gficht/OpenServo/img/electro.jpg

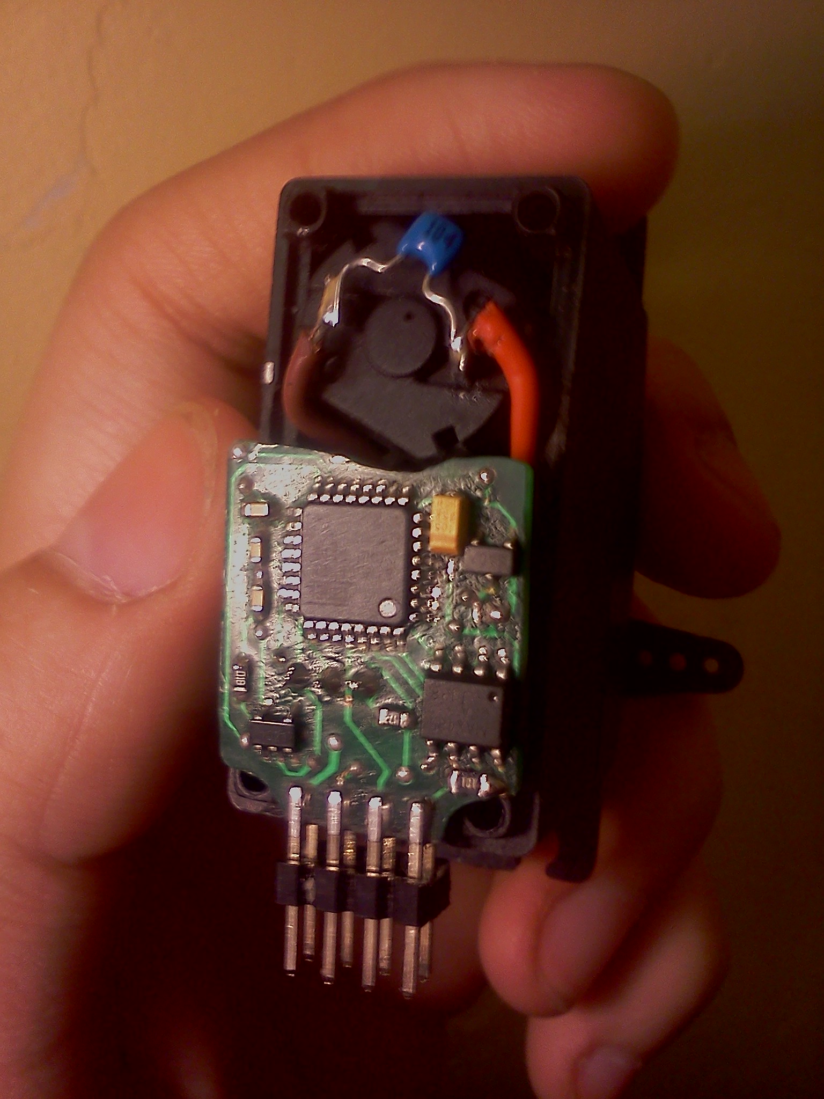
img/electro.jpg
