gficht/OpenServo/img/module.jpg

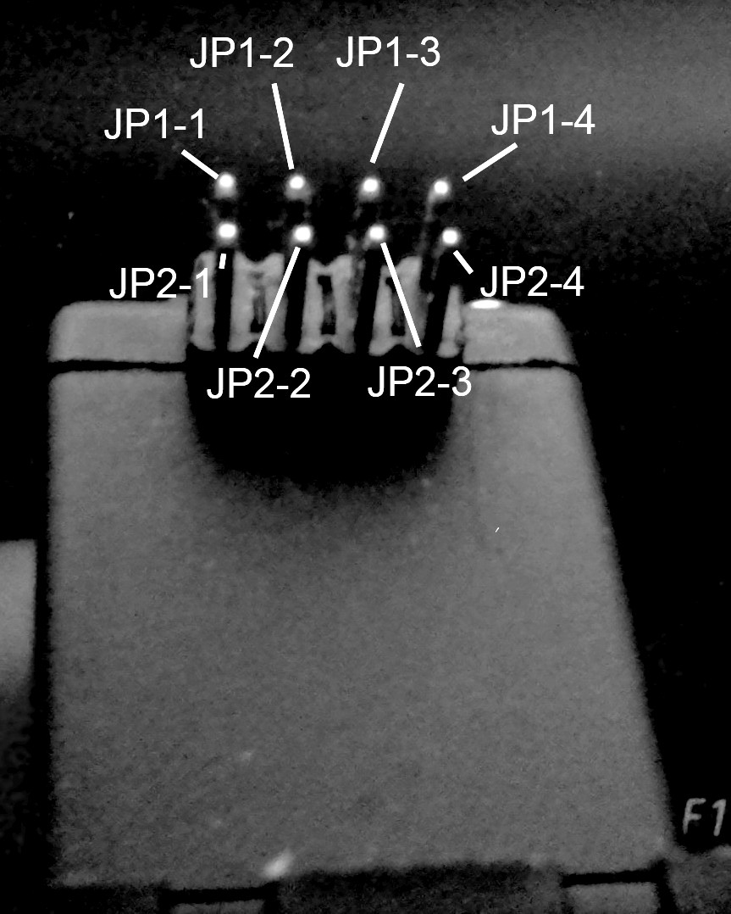
img/module.jpg
