gficht/OpenServo/tolinski.pdf

# Sterowniki robotów Projekt Openservo

### Jarosław Toli ´nski

### 31 maja 2012

## Spis tre´sci

1 Wst ˛ep teoretyczny | 3
1.2 Załozenia projektowe | ˙ | 3
1.3 Róznice | ˙ | 3
2 Hardware | 6
3 Oprogramowanie | 7
4 Dokumentacja programu | 8

## 1 Wst ˛ep teoretyczny

### 1.1 Czym jest Openservo?

OpenServo jest otwartym projektem zakładaj ˛acym projektowanie, budowanie oraz programowanie układów pełni ˛acych role sterowników do serwomechanizmów, prowadzonym przez Barry Carter’ a,

### 1.2 Załozenia projektowe ˙

Celem projektu było stworzenie sterownika seromechanizmu zdolnego do komunikacji po RS485. Na podstawie celów projektu wyznaczono nast ˛epuj ˛ace załozenia ˙ projektowe:

- zaprojektowanie układu elektronicznego oraz płytki PCB na podstawie projektu OpenServo,
- zmaksymalizowanie wykorzytania dost ˛epnego w ramach projektu OpenServo kodu i dodanie do niego załozonych wczesniej funkcjonalno´sci. ˙

### 1.3 Róznice ˙

Aby zapewni´c mozliwo´s´c komunikacji tworzonego OpenServa z u ˙ | zyciem RS485, do ˙
oryginalnego projektu elektroniki oraz firmware-u OpenServa wprowadzono kilka zmian:
- dodano układ MAX485, słuz ˛acy do komunikacji za pomoc ˛a interfejsu RS485, ˙
- ze wzgl ˛edu na niedost ˛epno´s´c oryginalnego regulatora napi ˛ecia, zast ˛apiono go układem MCP1701AT-5002I/CB, co wymusiło równiez zmian ˛e kondensa- ˙ torów w sekcji zasilania,
- z powodu konieczno´sci zarezerwowania miejsca na zł ˛aczu dla poł ˛acze ´n A i B interfejsu RS485, nie wyprowadzono lini SDA mikrokontrolera, co permanentnie uniemozliwia wykorzystanie TWI, ˙
- dodano obsług ˛e portu UART,
- utworzono namiastk ˛e protokołu słuz ˛acego do bezpiecznego zarz ˛adzania ser- ˙ wem,
- utworzono funkcje obsługuj ˛ace komendy OpenServa.

Sposób kontrolowania zaprojektowanego OpenServa jest podobny do oryginalnego projektu. Róznice to konieczno´s´c stosowania interfejsu RS485 oraz zastosowanie ˙ odpowiedniego protokołu komunikacji z serwem. Podobnie jak w przypadku komunikacji przez TWI, wymagane jest wysłanie: adresu serwa, komendy/polecenia, zaleznie od komendy, dodatkowo dwóch 16-bitowych słów danych (adresu re- ˙ jestru,zapisywana warto´s´c) oraz sumy CRC(modbus, polynomial 0xa001, warto´s´c pocz ˛atkowa 0xffff), słuz ˛acej do sprawdzenia poprawno´sci odebranych danych. ˙

### 1.4 Zł ˛acze modułu

Zł ˛acze modułu ma spełnia´c 3 funkcj ˛e: zasilania, komunikacji oraz programowania wewn ˛etrznego mikrokontrolera.


Rysunek 1: Zł ˛acze modułu

Tabela 1: Opis wyprowadze ´n modułu
Oznaczenie | Opis
JP1-1 | Zł ˛acze zasilania 6V (10V Max) lub 5V w trybie programowania
JP1-2 | Masa (GND)
JP1-3 | SCK (programowanie)
JP1-4 | Wyprowadzenie A interfejsu RS485
JP2-1 | MOSI(programowanie)
JP2-2 | MISO(programowanie)
JP2-3 | RESET (programowanie)
JP2-4 | Wyprowadzenie B interfejsu RS485

### 1.5 Komunikacja

Komunikacja z uzyciem portu UART odbywa si ˛e przy pr˛edko´sci transmisji (bau- ˙ drate) równej 19200. Zgodnie z ide ˛a interfejsu RS485, serwo jako urz ˛adzenie typu slave oczekuje rozkazów, wysyłaj ˛ac dane tylko wtedy kiedy wysłane zostanie odpowiednie z ˛adanie. W celu zapewnienia poprawno´sci transmisji oraz jak najlepszej ˙ integracji z istniej ˛acym firmwarem OpenServa zdecydowano si ˛e na stworzenie namiastki protokołu komunikacji. Komunikacja z serwem opiera si ˛e na wysyłaniu oraz ewentualnie odbieraniu ramek danych. Kazda ramka składa si ˛e z 9 bajtów ˙ danych. Dzi ˛eki temu mozliwe jest zaadresowanie 255 urz ˛adze ´n (0=adres broad- ˙
cast), zapiywanie i zadanie odczytania ka ˙ | zdego z rejetrów za pomoc ˛a jednej ramki ˙
danych przy jednoczesnej gwarancji spójno´sci i poprawno´sci zapisanych/odczytanych danych. Sterowanie serwem opiera si ˛e na tej samej zasadzie jak w oryginalnym projekcie: zmiana pozycji, nastaw PID, lub jakichkolwiek innych ustawie ´n nast ˛epuje poprzez zapis danych (pozycji, nastaw) do odpowiednich rejestrów. Domy´slny adres urz ˛adzenia to 0x10. Zmiana rejestru jest mozliwa z poziomu kodu ˙ oraz przez zapis odpowiedniego rejestru. Rejestr pozycji serwa jest 16-bitowy, jed-

Tabela 2: Opis ramki danych
Zawiera: | Bajt:
1 | ’<’
2 | adres urz ˛adzenia
3 | polecenie
4 | MSB data1
5 | LSB data1
6 | MSB data2
7 | LSB data2
8 | MSB CRC16
9 | LSB CRC16

nak wykorzystywany zakres warto´sci to 0-1023. W OpenServie dodatkowo wpro-
wadzona jest blokada maj ˛aca na celu ograniczenie zuzycia serwa zaw ˛e ˙ | zaj ˛ace ten ˙
zakres do 96-928. Działanie wszystkich rejestrów jest tozsame z oryginalnym. Je- ˙ dyn ˛a róznic ˛a jest brak blokady zapisu istotnych rejestrów. ˙

## 2 Hardware

### 2.1 Projekt

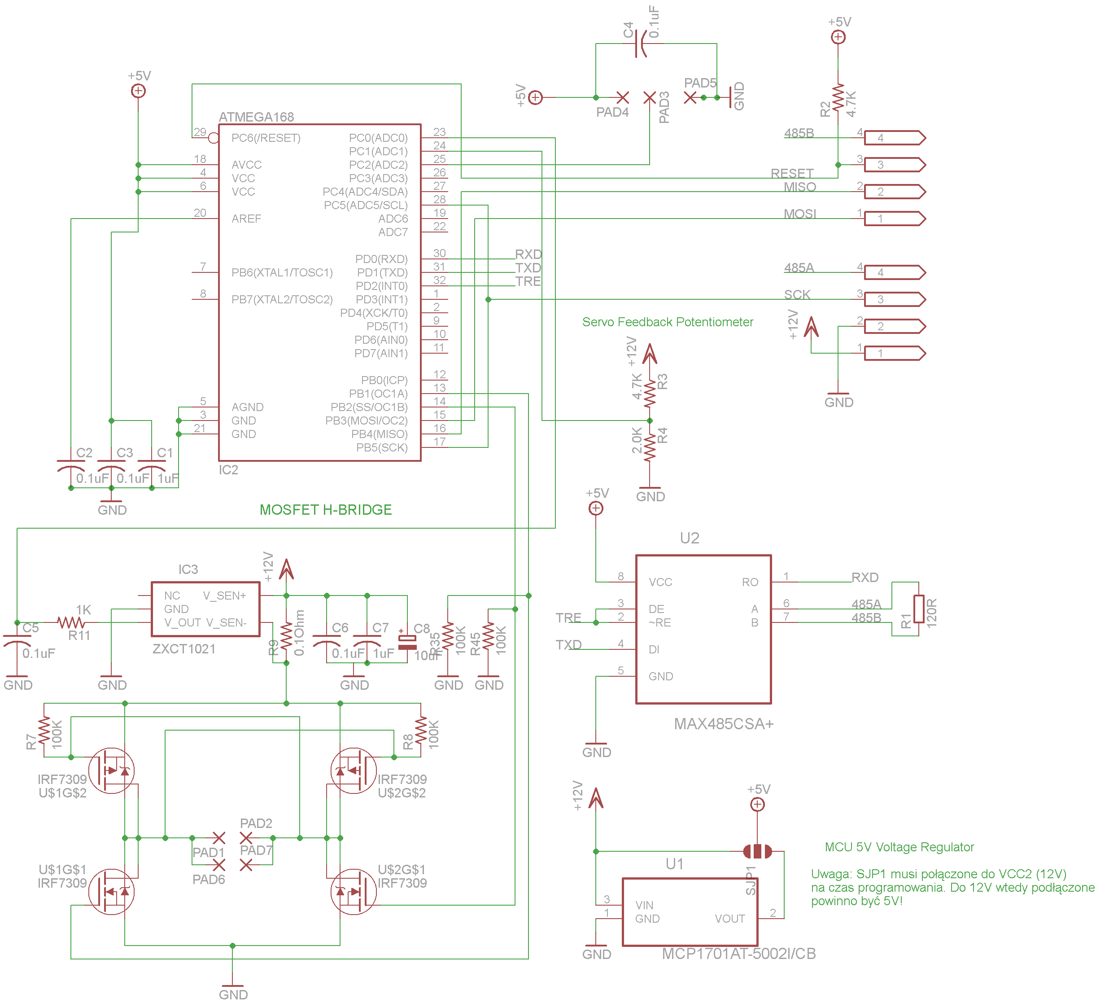
[picture p3: figure]

Rysunek 2: Schemat

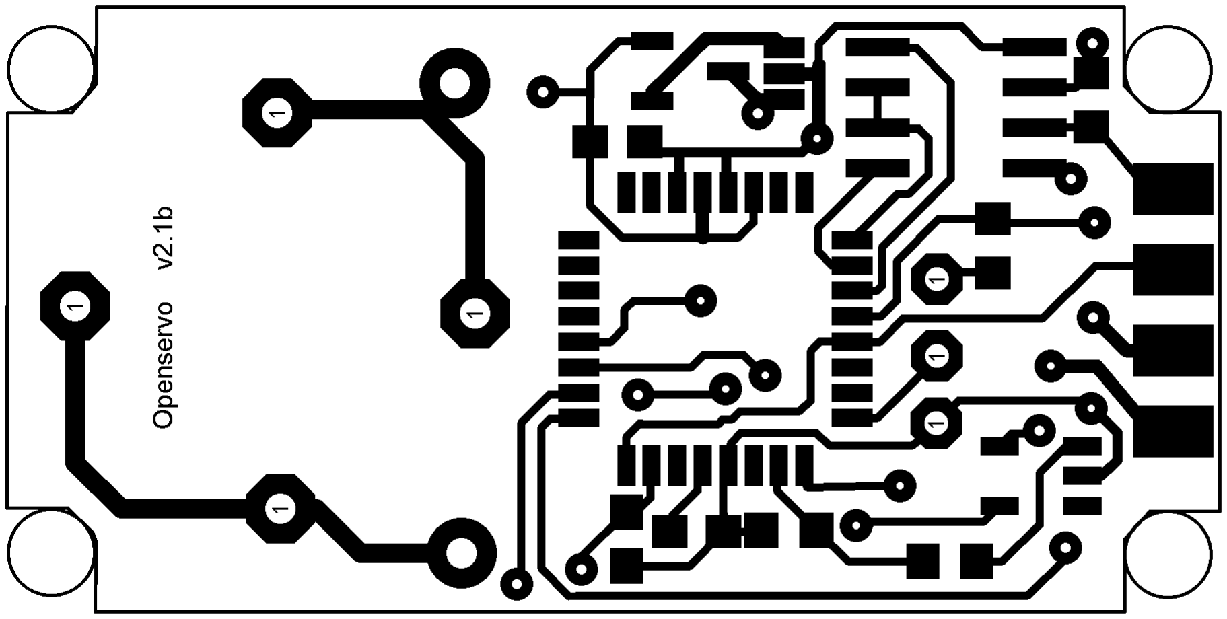
[picture p4: figure]

Rysunek 3: Projekt PCB (góra)

## 3 Oprogramowanie

Firmware urz ˛adzenia opiera si ˛e głównie na oryginalnym oprogramowaniu Open-Serva. Zostało ono odpowiednio rozszerzone aby spełnia´c cele i załozenia pro- ˙ jektu. Ponadto niezaimplementowana został ˛a ochrona waznych rejestrów - polece- ˙ nia WRITE_ENABLE, WRITE_DISABLE nie maj ˛a efektu. Nastawy PID zostały dobrane metod ˛a Zieglera-Nicholsa. Tabela rejetrów pobrana ze strony Projektu Open-Servo:

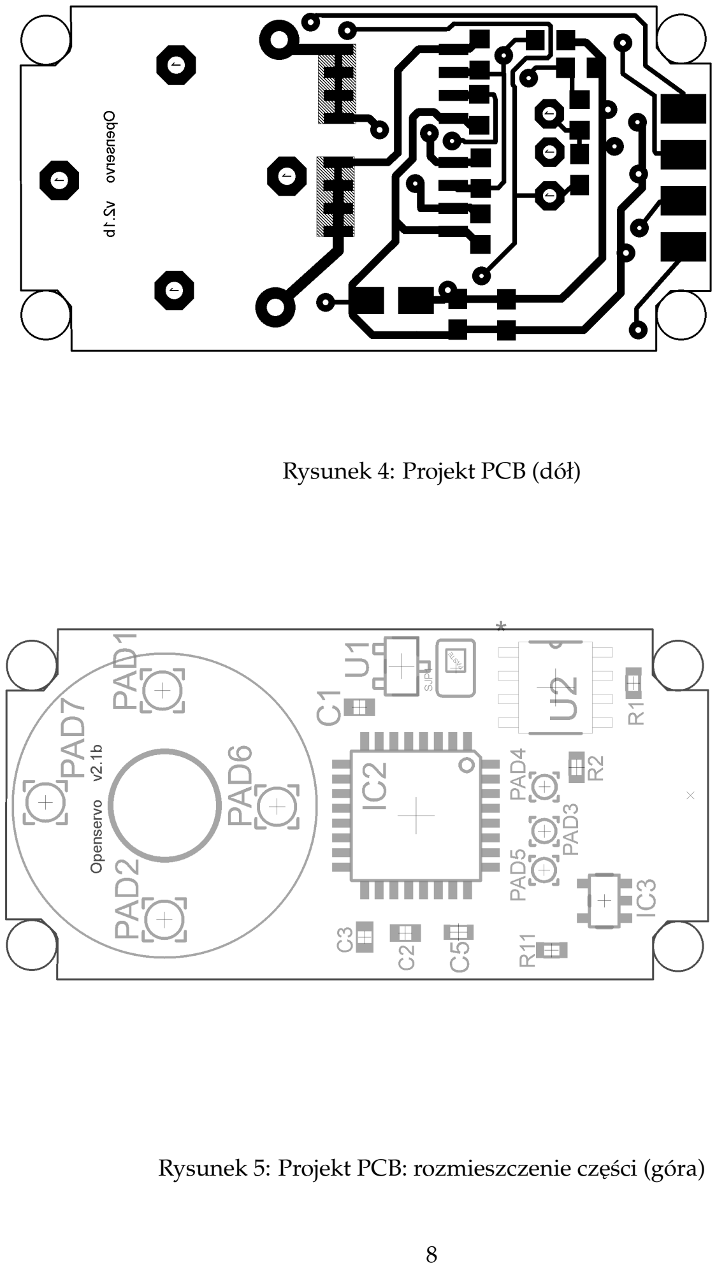
[picture p5: page 8]

Rysunek 4: Projekt PCB (dół)

Rysunek 5: Projekt PCB: rozmieszczenie cz ˛e´sci (góra)

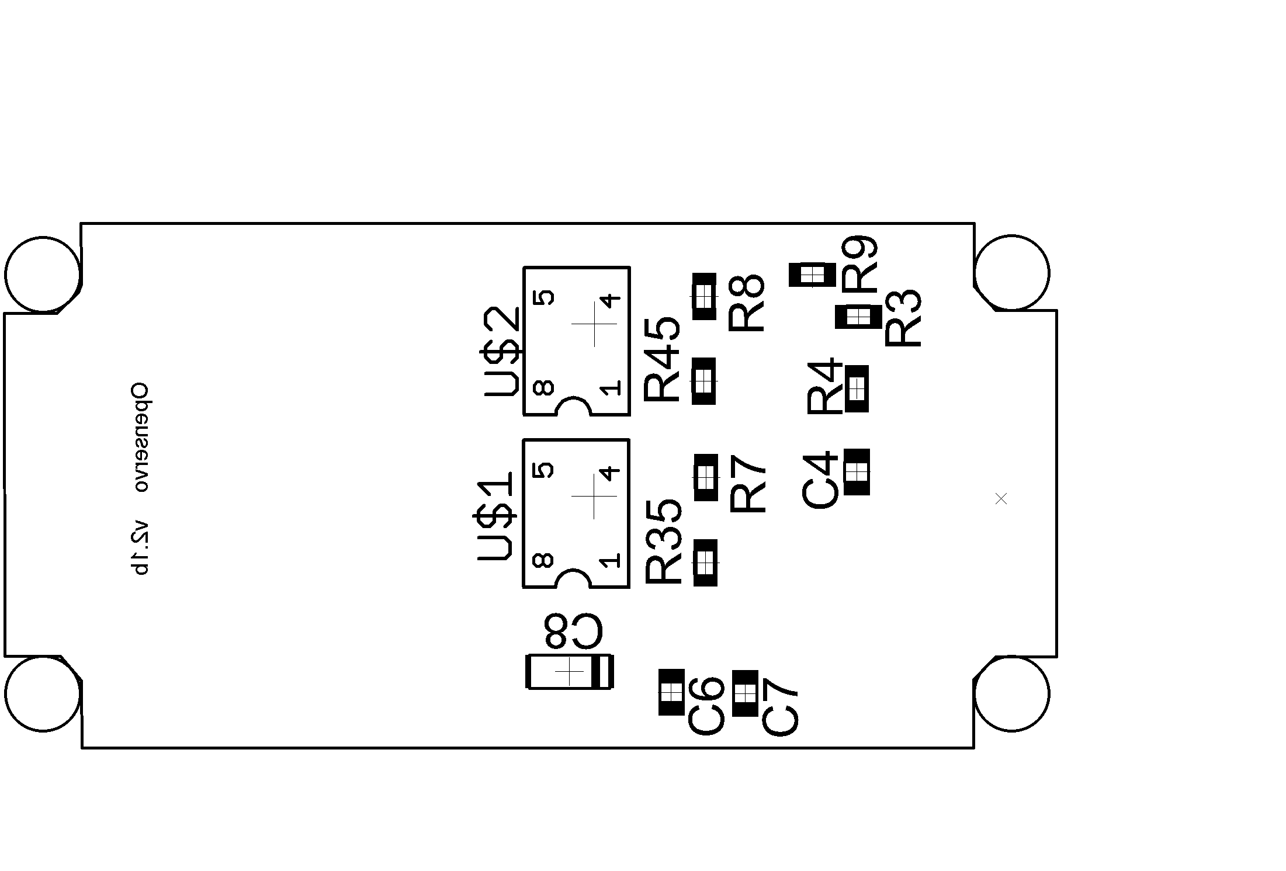
[picture p6: figure]

Rysunek 6: Projekt PCB: rozmieszczenie cz ˛e´sci (dół)


Rysunek 7: Projekt PCB (góra)

Tabela 3: Rejestry OpenServa
Address | Name | Type | Description
0x00 | DEVICE_TYPE | R/O | Device type - 1
0x01 | DEVICE_SUBTYPE | R/O | Device subtype - 1
0x02 | VERSION_MAJOR | R/O | Major version number
0x03 | VERSION_MINOR | R/O | Minor version number
0x04 | FLAGS_HI | R/O | Flags high byte
0x05 | FLAGS_LO | R/O | Flags low byte
0x06 | TIMER_HI | R/O | Timer high byte
0x07 | TIMER_LO | R/O | Timer low byte
0x08 | POSITION_HI | R/O | Servo position high byte
0x09 | POSITION_LO | R/O | Servo position low byte
0x0A | VELOCITY_HI | R/O | Servo velocity high byte
0x0B | VELOCITY_LO | R/O | Servo velocity low byte
0x0C | POWER_HI | R/O | Servo power high byte
0x0D | POWER_LO | R/O | Servo power low byte
0x0E | PWM_CW | R/O | PWM clockwise value
0x0F | PWM_CCW | R/O | PWM counter-clockwise value
0x10 | SEEK_HI | R/W | Seek position high byte
0x11 | SEEK_LO | R/W | Seek position low byte
0x12 | SEEK_VELOCITY_HI | R/W | Speed seek position high byte
0x13 | SEEK_VELOCITY_LO | R/W | Speed seek position low byte
0x14 | VOLTAGE_HI | R/W | Battery Voltage value high byte
0x15 | VOLTAGE_LO | R/W | Battery Voltage value low byte
0x16 | CURVE_RESERVED | R/W | reserved curve data
0x17 | CURVE_BUFFER | R/W | Remaining curve buffer space
0x18 | CURVE_DELTA_HI | R/W | Curve Time delta high byte
0x19 | CURVE_DELTA_LO | R/W | Curve Time delta low byte
0x1A | CURVE_POSITION_HI | R/W | Curve position high byte
0x1B | CURVE_POSITION_LO | R/W | Curve position low byte
0x1C | CURVE_IN_VELOCITY_HI | R/W | Curve in velocity high byte
0x1D | CURVE_IN_VELOCITY_LO | R/W | Curve in velocity low byte
0x1E | CURVE_OUT_VELOCITY_HI | R/W | Curve out velocity high byte
0x1F | CURVE_OUT_VELOCITY_LO | R/W | Curve out velocity low byte
0x20 | TWI_ADDRESS | R/W P | TWI address of servo
0x21 | PID_DEADBAND | R/W P | Programmable PID deadband value
0x22 | PID_PGAIN_HI | R/W P | PID proportional gain high byte
0x23 | PID_PGAIN_LO | R/W P | PID proportional gain low byte
0x24 | PID_DGAIN_HI | R/W P | PID derivative gain high byte
0x25 | PID_DGAIN_LO | R/W P | PID derivative gain low byte
0x26 | PID_IGAIN_HI | R/W P | PID integral gain high byte
0x27 | PID_IGAIN_LO | R/W P | PID integral gain low byte
0x28 | PWM_FREQ_DIVIDER_HI | R/W P | PWM frequency divider high byte
0x29 | PWM_FREQ_DIVIDER_LO | R/W P | PWM frequency divider low byte
0x2A | MIN_SEEK_HI | R/W P | Minimum seek position high byte
0x2B | MIN_SEEK_LO | R/W P | Minimum seek position low byte
0x2C | MAX_SEEK_HI | R/W P | Maximum seek position high byte
0x2D | MAX_SEEK_LO | R/W P | Maximum seek position low byte
0x2E | REVERSE_SEEK | R/W P | Reverse seek sense
0x2F | RESERVED | R/W P

Tabela 4: Komendy OpenServa
Command | Name | Description
0x00...0x7F | reserved | Reserved for data addresses (msb = 0)
0x80 | RESET | Reset microcontroller
0x81 | CHECKED_TXN | Read/Write registers with simple checksum
0x82 | PWM_ENABLE | Enable PWM to motors
0x83 | PWM_DISABLE | Disable PWM to servo motors
0x84 | WRITE_ENABLE | Enable write of r/w protected registers
0x85 | WRITE_DISABLE | Disable write of r/w protected registers
0x86 | REGISTERS_SAVE | Save r/w protected registers fo EEPROM
0x87 | REGISTERS_RESTORE | Restore r/w protected registers from EEPROM
0x88 | REGISTERS_DEFAULT | Restore r/w protected registers to defaults
0x89 | EEPROM_ERASE | Erase the AVR EEPROM
0x90 | VOLTAGE_READ | Request a new Voltage sample
0x91 | CURVE_MOTION_ENABLE | Enable curve based motion
0x92 | CURVE_MOTION_DISABLE | Disable curve based motion
0x93 | CURVE_MOTION_RESET | Clear the curve buffer
0x94 | CURVE_MOTION_APPEND | Append a new curve
