gficht/OpenServo/adapter/adapter.png

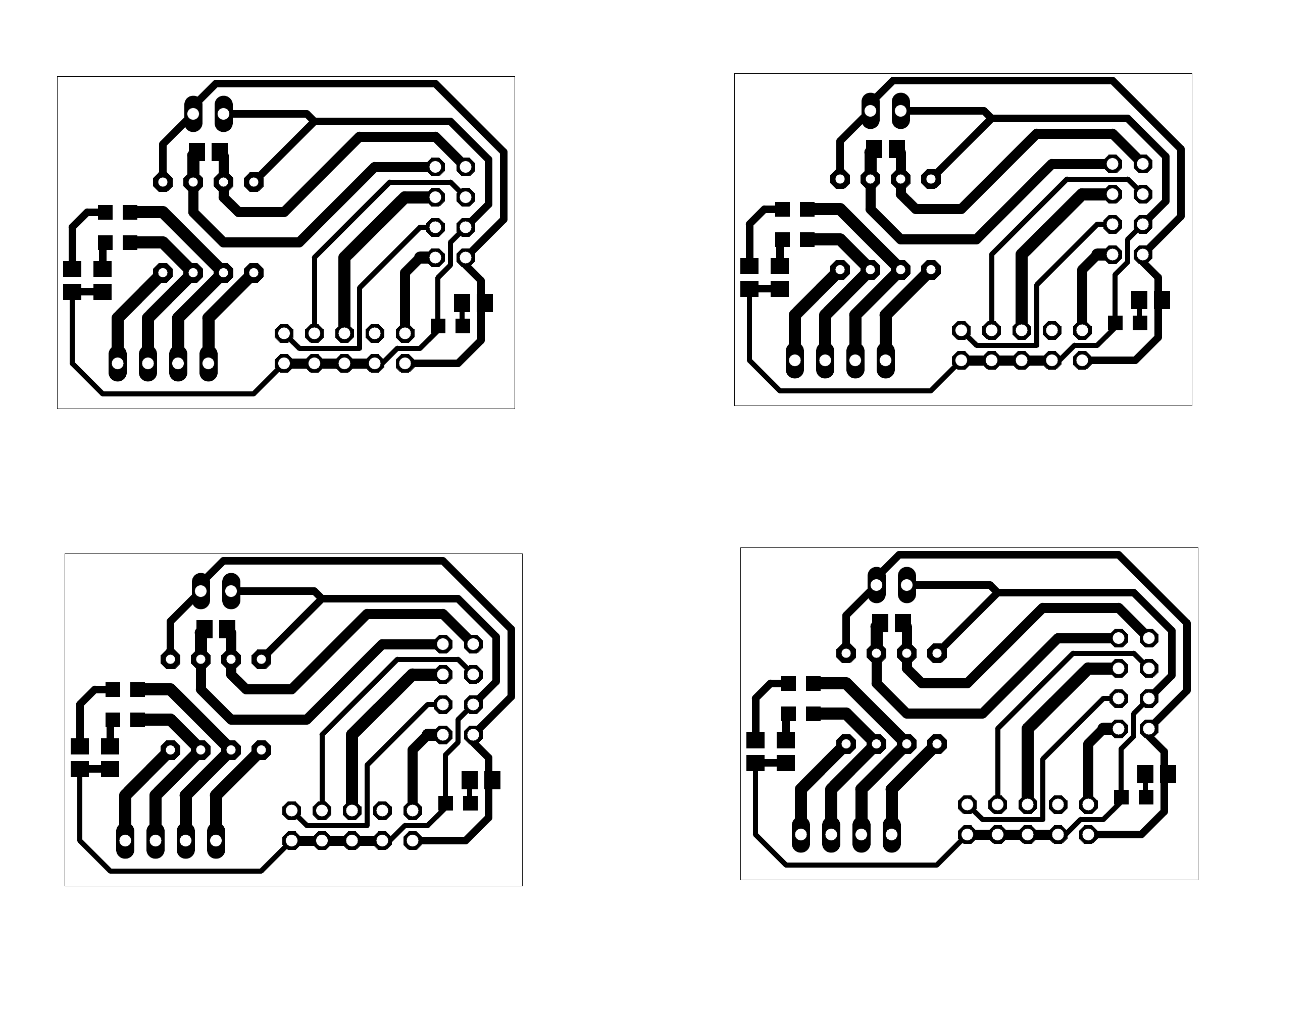
adapter/adapter.png
