gficht/OpenServo/adapter/adapteropis.png

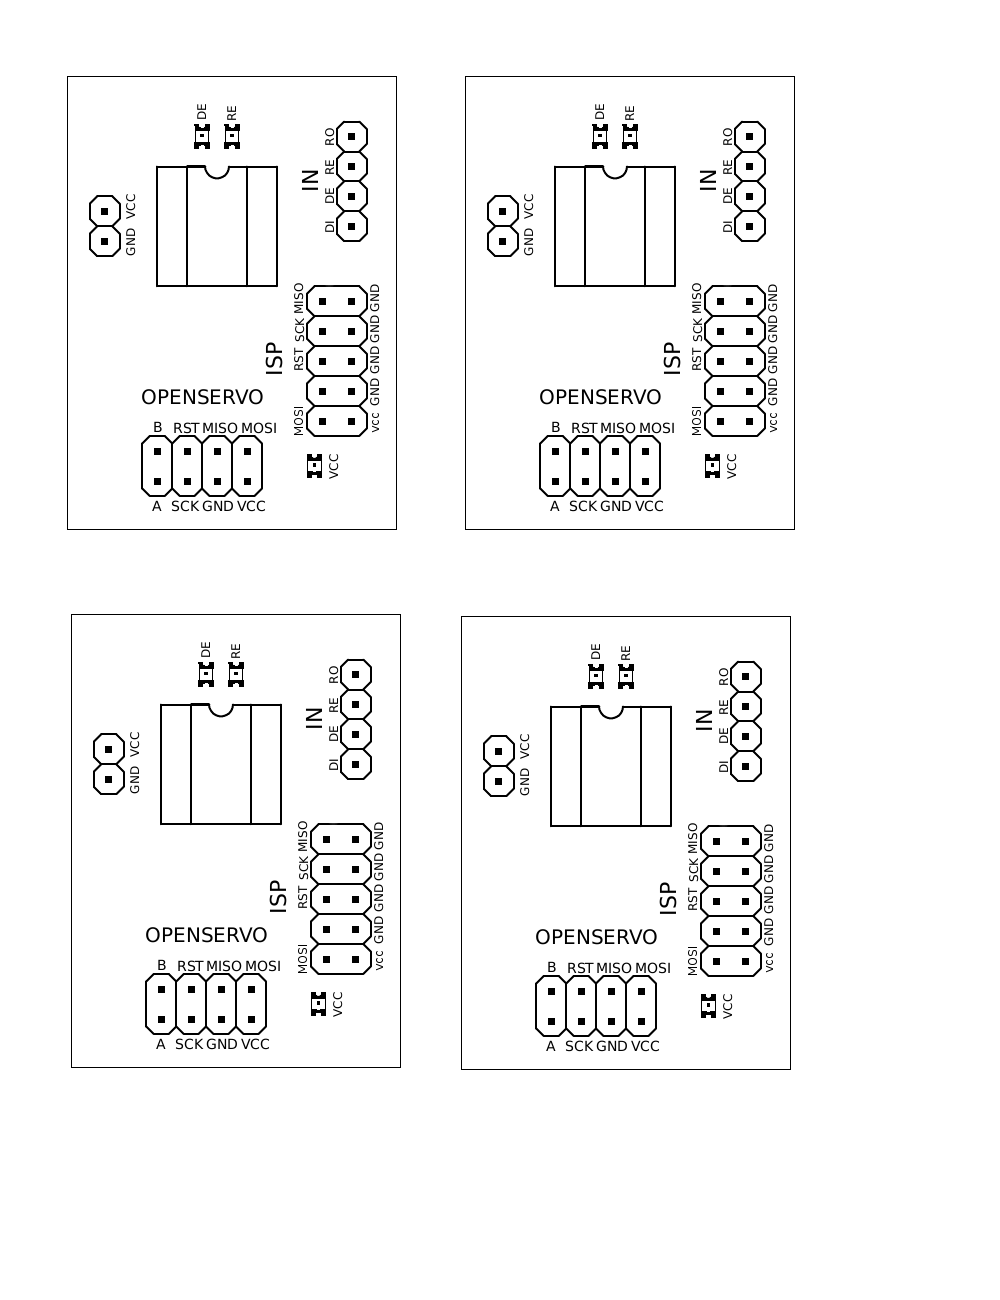
adapter/adapteropis.png
