gficht/OpenServo/img/brd-btt.png

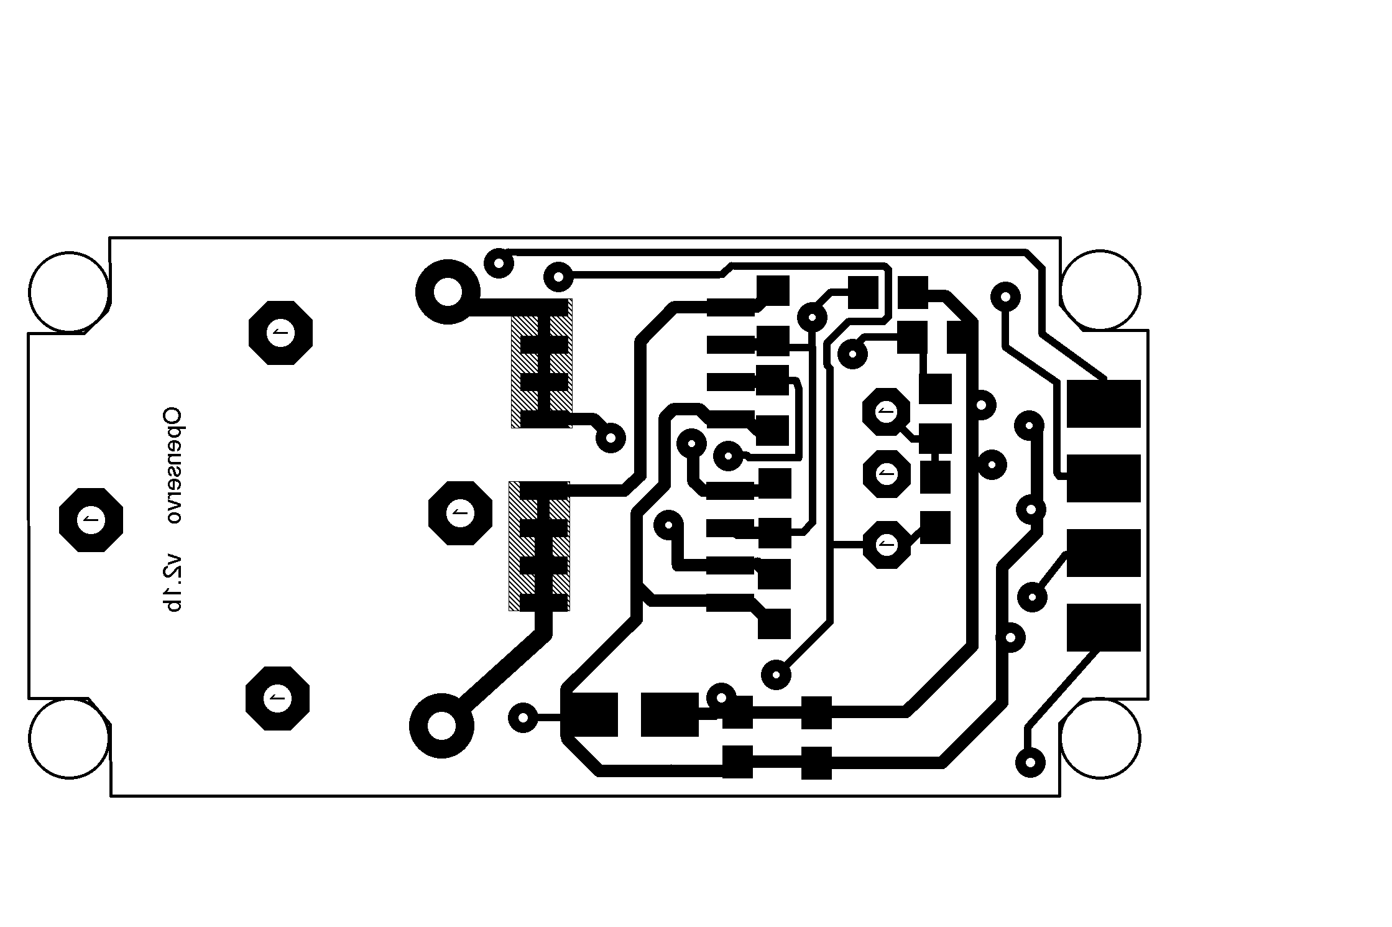
img/brd-btt.png
