gficht/OpenServo/img/brd-top.png

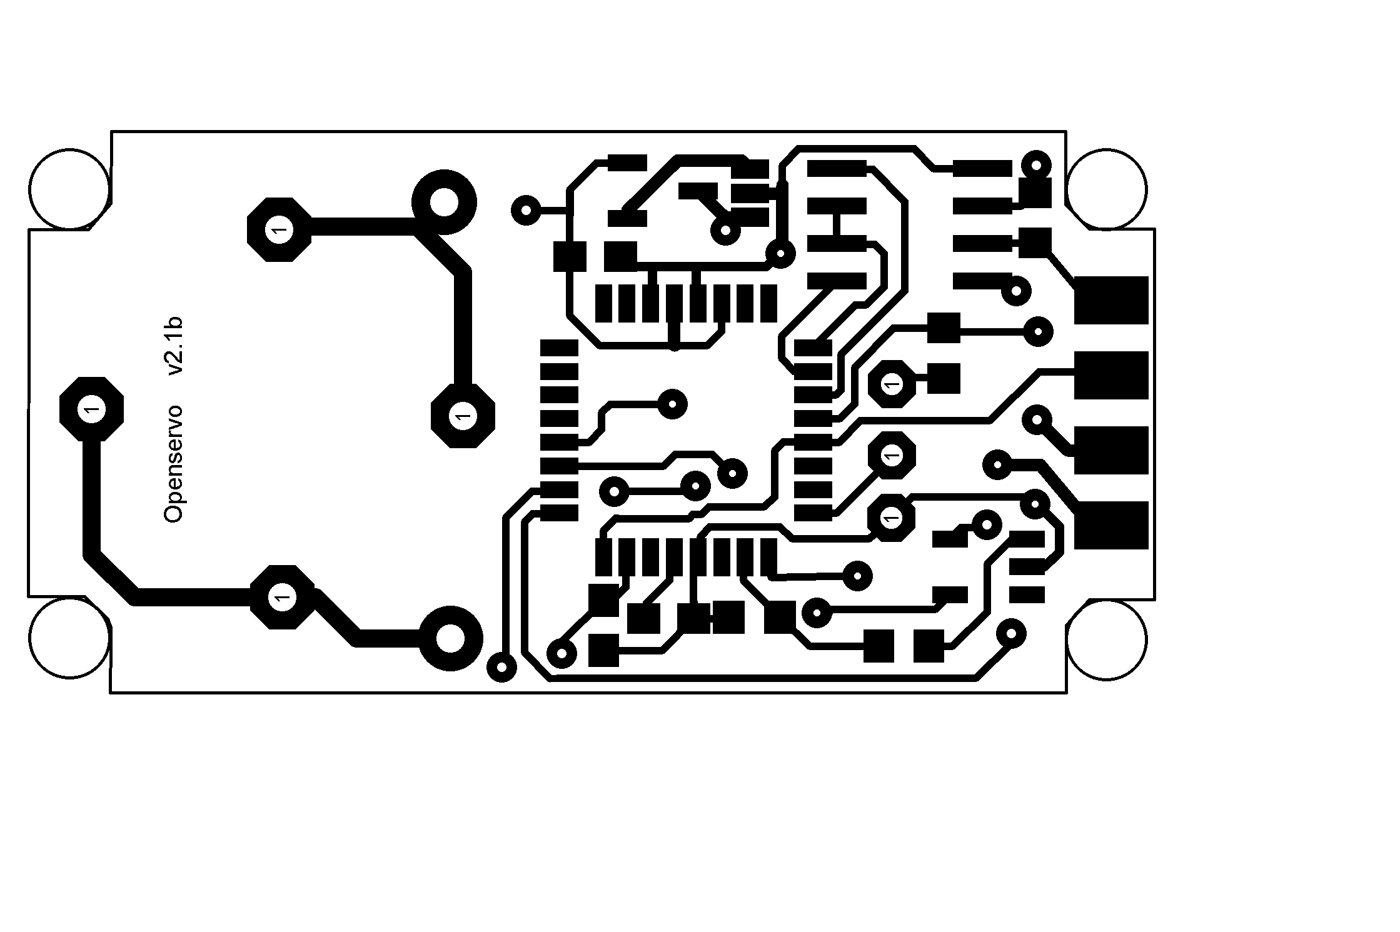
img/brd-top.png
