gficht/OpenServo/img/brd-top-parts.png

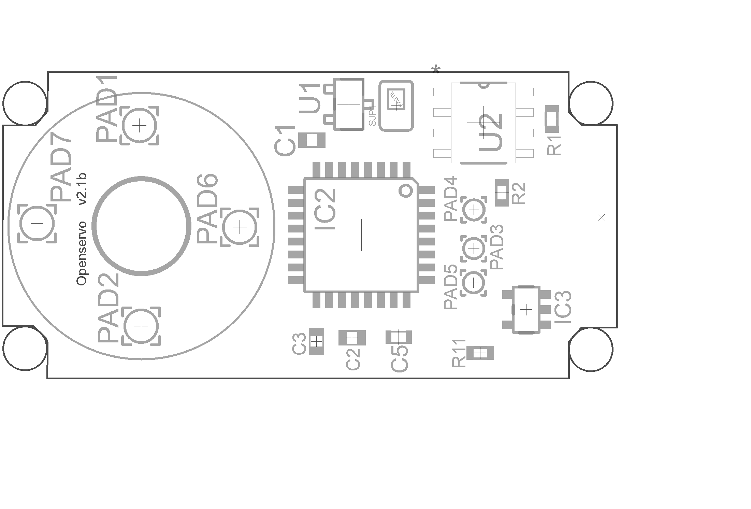
img/brd-top-parts.png
