gficht/OpenServo/adapter/adapter.pdf

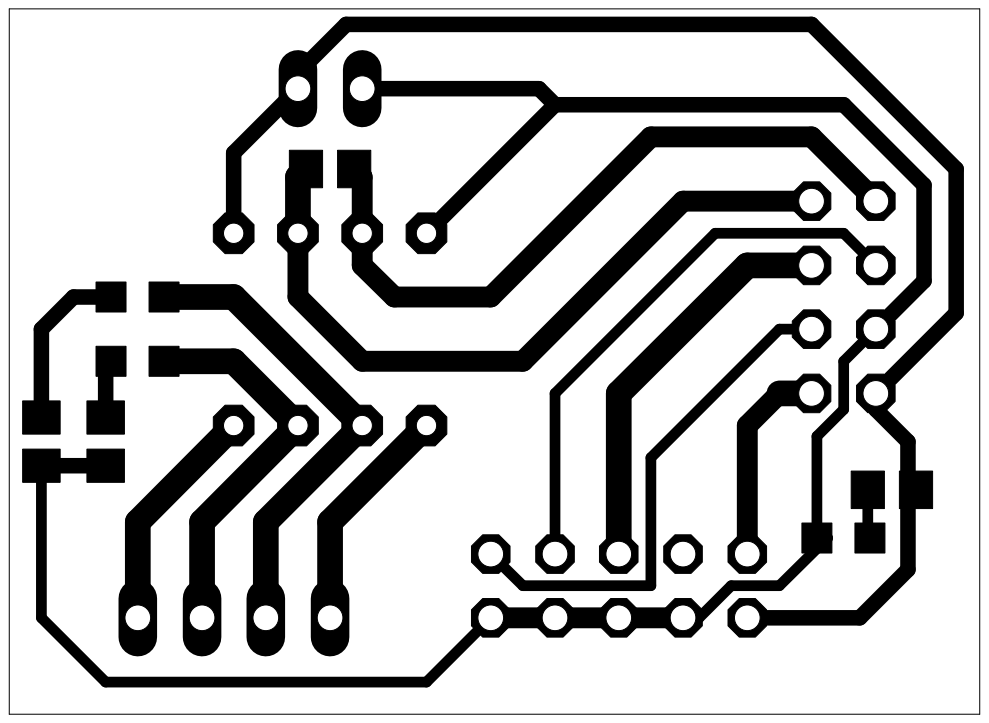
[picture p12: page 1]
