gficht/OpenServo/adapter/adapteropis.pdf

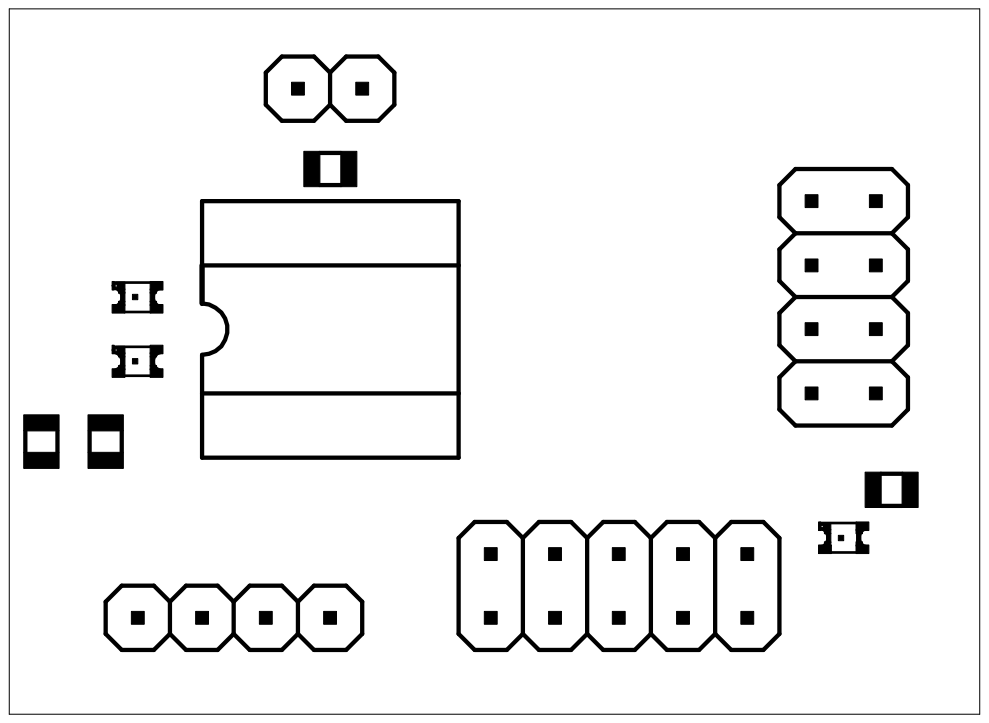
[picture p13: page 1]
