gficht/OpenServo/adapter/adapter.brd

## EAGLE design adapter/adapter.brd (2015-03-31)

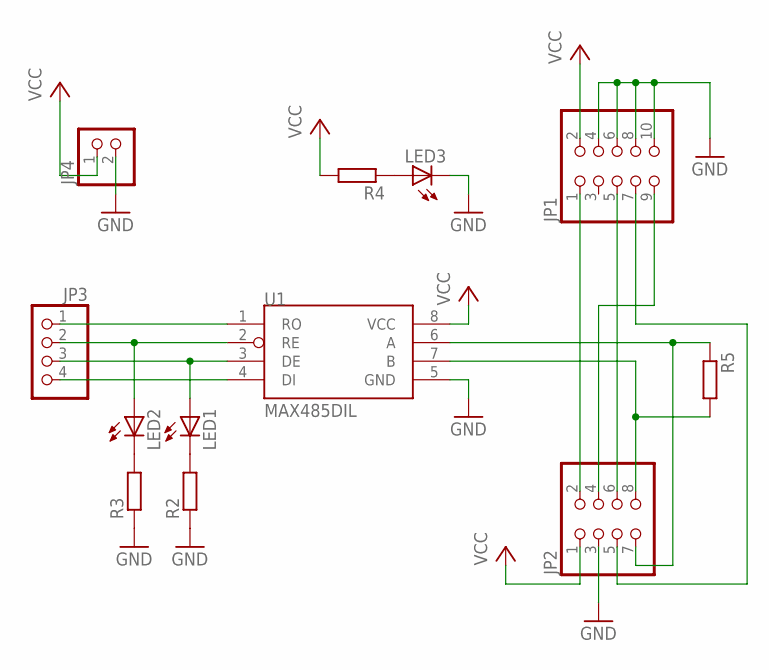
[picture p14: schematic adapter.sch]

Parts:
JP1: PINHD-2X5; 2X05
JP2: PINHD-2X4; 2X04
JP3: PINHD-1X4; 1X04
JP4: PINHD-1X2; 1X02
LED1, LED2, LED3: LEDCHIPLED_0805; CHIPLED_0805
R2, R3, R4, R5: R-EU_R0805; R0805
U1: MAX485DIL; DIL08

Connections:
A: JP2.7, R5.1, U1.6 (A)
B: JP2.8, R5.2, U1.7 (B)
GND: JP1.4, JP1.6, JP1.8, JP1.10, JP2.3, JP4.2, LED3.C, R2.1, R3.1, U1.5 (GND)
MISO: JP1.9, JP2.4
MOSI: JP1.1, JP2.2
unnamed: JP3.1, U1.1 (RO)
unnamed: JP3.2, LED2.A, U1.2 (RE)
unnamed: JP3.3, LED1.A, U1.3 (DE)
unnamed: JP3.4, U1.4 (DI)
unnamed: LED2.C, R3.2
unnamed: LED1.C, R2.2
unnamed: LED3.A, R4.1
RST: JP1.5, JP2.6
SCK: JP1.7, JP2.5
VCC: JP1.2, JP2.1, JP4.1, R4.2, U1.8 (VCC)

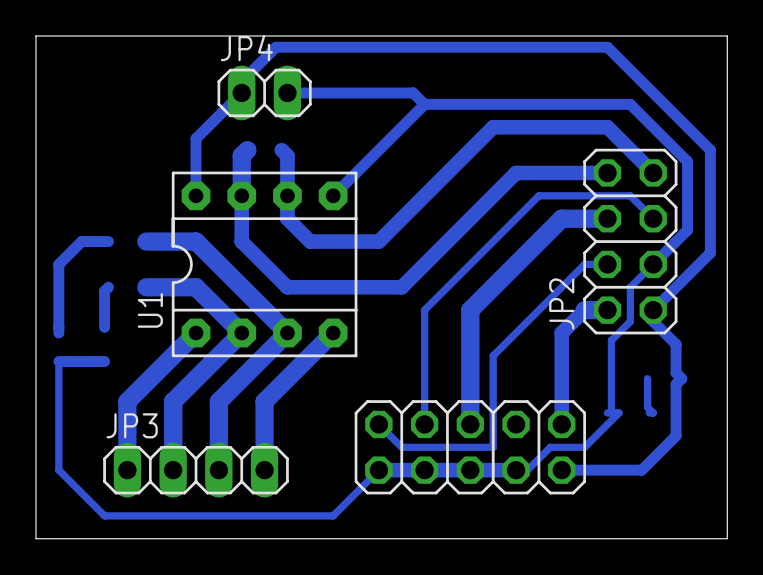
[picture p15: board adapter.brd from above]

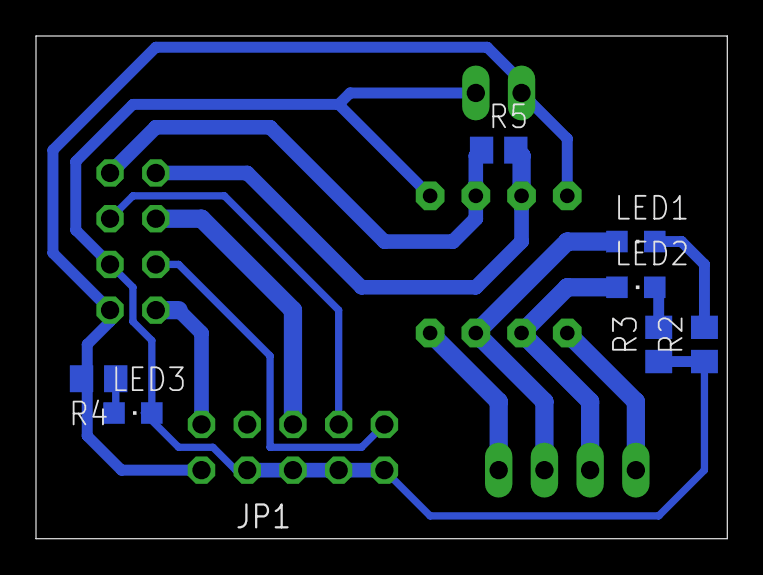
[picture p16: board adapter.brd from below]

Board: 2 copper layers, 38.4 x 27.9 mm, 12 parts (7 on the bottom side), 15 nets.
