gficht/OpenServo/eagle/Poprawiona.brd

## EAGLE design eagle/Poprawiona.brd (2015-03-31)

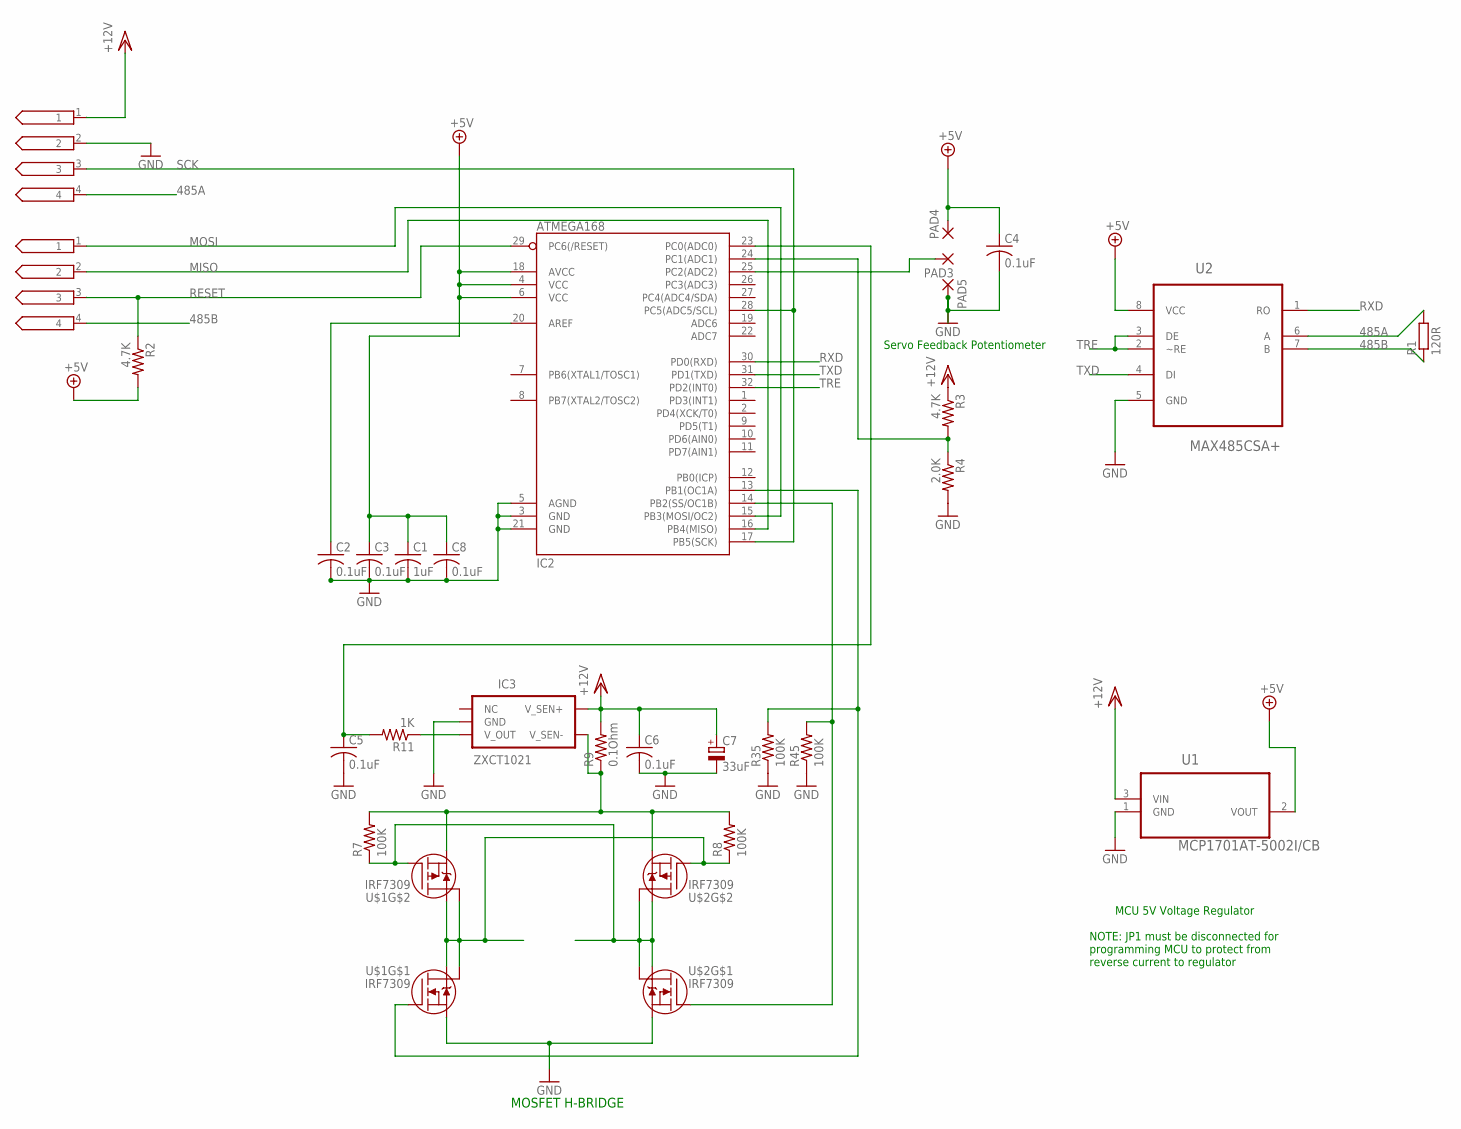
[picture p17: schematic Poprawiona.sch]

Parts:
C1: 1uF; C0603
C2, C3, C4, C6, C8: 0.1uF; C0603
C5: 0.1uF; C0603K
C7: 33uF; B/3528-21R
IC2: ATMEGA168; TQFP32-08
IC3: ZXCT1021; SOT23-5
JP1, JP2: 4-EDGEVERSION2; 4-PIN-EDGE-V2
PAD3, PAD4, PAD5: 1,6/0,8
R1: 120R; R0603
R2, R3: 4.7K; R0603
R4: 2.0K; R0603
R7, R8, R35, R45: 100K; R0603
R9: 0.1Ohm; R0603
R11: 1K; R0603
U1: MCP1701AT-5002I/CB; SOT95P255X145-3N
U2: MAX485CSA+; SOIC127P600X175-8N
U$1, U$2: IRF7309; SO8-2

Connections:
485A: JP1.4, R1.2, U2.6 (A)
485B: JP2.4, R1.1, U2.7 (B)
+5V: C1.1, C3.1, C4.1, C8.1, IC2.4 (VCC), IC2.6 (VCC), IC2.18 (AVCC), PAD4.1, R2.2, U1.2 (VOUT), U2.8 (VCC)
CURRENT: C5.1, IC2.23 (PC0(ADC0)), R11.2
GND: C1.2, C2.2, C3.2, C4.2, C5.2, C6.2, C7.-, C8.2, IC2.3 (GND), IC2.5 (AGND), IC2.21 (GND), IC3.2 (GND), JP1.2, PAD5.1, R4.2, R35.1, R45.1, U1.1 (GND), U2.5 (GND), U$1.1 (S), U$2.1 (S)
MISO: IC2.16 (PB4(MISO)), JP2.2
MOSI: IC2.15 (PB3(MOSI/OC2)), JP2.1
unnamed: R7.1, U$1.4 (G), U$2.5 (D), U$2.6 (D), U$2.7 (D), U$2.8 (D)
unnamed: IC3.3 (V_OUT), R11.1
unnamed: IC3.5 (V_SEN-), R7.2, R8.2, R9.1, U$1.3 (S), U$2.3 (S)
unnamed: IC2.14 (PB2(SS/OC1B)), R45.2, U$2.2 (G)
unnamed: IC2.25 (PC2(ADC2)), PAD3.1
unnamed: IC2.13 (PB1(OC1A)), R35.2, U$1.2 (G)
unnamed: C2.1, IC2.20 (AREF)
unnamed: IC2.24 (PC1(ADC1)), R3.2, R4.1
unnamed: R8.1, U$1.5 (D), U$1.6 (D), U$1.7 (D), U$1.8 (D), U$2.4 (G)
RESET: IC2.29 (PC6(/RESET)), JP2.3, R2.1
RXD: IC2.30 (PD0(RXD)), U2.1 (RO)
SCK: IC2.17 (PB5(SCK)), IC2.28 (PC5(ADC5/SCL)), JP1.3
TRE: IC2.32 (PD2(INT0)), U2.2 (~RE), U2.3 (DE)
TXD: IC2.31 (PD1(TXD)), U2.4 (DI)
VCC/2: C6.1, C7.+, IC3.4 (V_SEN+), JP1.1, R3.1, R9.2, U1.3 (VIN)

Notes on the sheet:
MOSFET H-BRIDGE
MCU 5V Voltage Regulator
NOTE: JP1 must be disconnected for
programming MCU to protect from
reverse current to regulator
Servo Feedback Potentiometer

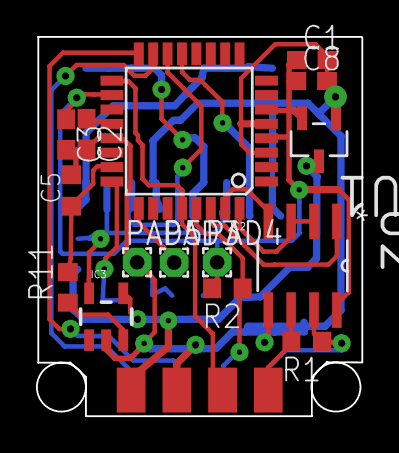
[picture p18: board Poprawiona.brd from above]

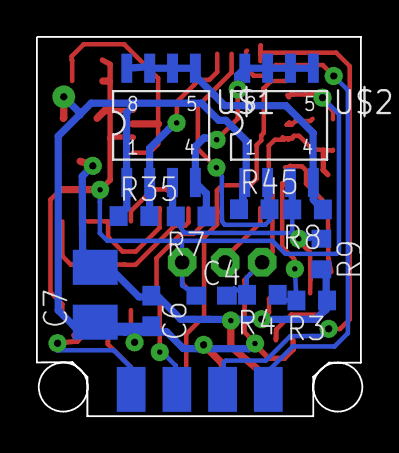
[picture p19: board Poprawiona.brd from below]

Board: 2 copper layers, 18.0 x 21.1 mm, 29 parts (13 on the bottom side), 22 nets.
